OksarD/spm_model/documents/Honours Project parts list.xlsx

Parts List
Seller | Name/Description | Unit Quantity | Unit Cost | Total Cost | URL
RS Components | 50*80D 15W Bearing | 2 | $23.23 | $46.46 | https://au.rs-online.com/web/p/ball-bearings/6190777?gb=s
RS Components | 35*62D 14W Bearing | 2 | $14.89 | $29.78 | https://au.rs-online.com/web/p/ball-bearings/6190682?gb=s
RS Components | 20*42D 12W Bearing | 2 | $8.42 | $16.84 | https://au.rs-online.com/web/p/ball-bearings/6190424?gb=s
RS Components | 5*16D 5W Bearing | 3 | $3.89 | $70.02 | https://au.rs-online.com/web/p/ball-bearings/1883316?gb=s
RS Components | Timing pulley 3M 12T 9W | 3 | $9.30 | $27.90 | https://au.rs-online.com/web/p/belt-pulleys/2365389?gb=s
RS Components | Timing Belt 3M 140T 9W 420mm | 18 | $16.52 | $49.56 | https://au.rs-online.com/web/p/timing-belts/2042925?gb=s
Core Electronics | SparkFun 6 Degrees of Freedom Breakout - LSM6DSO (Qwiic) | 1 | $27.75 | $27.75 | SparkFun 6 Degrees of Freedom Breakout - LSM6DSO (Qwiic) | Buy in Australia | SEN-18020 | Sparkfun | Core Electronics (https://core-electronics.com.au/sparkfun-6-degrees-of-freedom-breakout-lsm6dso-qwiic.html)
Core Electronics | Slip Ring - 12 Wire (2A) | 1 | $47.90 | $47.90 | Slip Ring - 12 Wire (2A) | Buy in Australia | ROB-13065 | Sparkfun | Core Electronics (https://core-electronics.com.au/slip-ring-12-wire-2a.html)
Bambu Lab | PC (Black) 1kg Filament | 1 | $61.99 | $61.99 | https://au.store.bambulab.com/products/pc-filament
Bambu Lab | PETG HF (Blue) 1kg Filament | 1 | $30.99 | $30.99 | https://au.store.bambulab.com/products/petg-hf
 |  |  | Subtotal | $409.19
