OksarD/spm_model/Arduino/TiltTableTest/Read_me.txt

Press D to disable the motors.
Enter the command in the following format to tilt the table in the Roll, Pitch and Yaw directions: MR0P0Y0
where the number after R is the roll value, the number after P is the pitch value and the number after Y is the yaw value.
