OksarD/spm_model/Arduino/TiltTableTest/forward_kinematic_lookup.cpp

#include "project.hpp"

#ifdef FPK_YAW_LOOKUP_TABLE
const float yaw_table[] = {
  -999, -999, -999, -999, -999, -999, -999, -999, -999, -999, -999, -999, -999, -999, -999, -999, -999, -999, -999, -999, -999, -999, -999, -999, -999, -999, -999, -999, -999, -999, -999, -999, -999, -999, -999, -999, -999, -999, -999, -999, -999, -999, -999, -999, -999, -999, -999, -999, -999, -999, -999, -999, -999, -999, -999, -999, -999, -999, -999, 0.891973, 0.853819, 0.817185, 0.782015, 0.748247, 0.715818, 0.684663, 0.654719, 0.625927, 0.598229, 0.571574, 0.545913, 0.521203, 0.497406, 0.474486, 0.452415, 0.431168, 0.410722, 0.391061, 0.372173, 0.354047, 0.336677, 0.320060, 0.304196, 0.289086, 0.274734, 0.261144, 0.248322, 0.236273, 0.225001, 0.214510, 0.204798, 0.195862, 0.187694, 0.180280, 0.173602, 0.167633, 0.162342, 0.157694, 0.153645, 0.150150, 0.147161, 0.144627, 0.142497, 0.139494, 0.139255, 0.138050, 0.137066, 0.136265, 0.135614, 0.135082, 0.134645, 0.134280, 0.133971, 0.133703, 0.133464, 0.133246, 0.133042, 0.132850, 0.132668, 0.132494, 0.125346, 0.125095, 0.132043, -999, -999, -999, -999, -999, -999, -999, -999, -999, -999, -999, -999, -999, -999, -999, -999, -999, -999, -999, -999, -999, -999, -999, -999, -999, -999, -999, -999, -999, -999, -999, -999, -999, -999, -999, -999, -999, -999, -999, -999, -999, -999, -999, -999, -999, -999, -999, -999, -999, -999, -999, -999, -999, -999, -999, -999, -999, 
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
};
#endif
