OksarD/spm_model/(commit log)

2025-05-19 fpk WIP
    fpk not working but right idea
    use entire solve_ipk function instead
    [main.py, manipulator.py]
2025-05-20 fpk up to V vectors
    decoupled yaw at the input for fpk
    fpk works now for full range (+/- pi)
2025-05-22 solve for rotation matrix as opposed to co-ordinates
    The positional kinematics now output a rotation matrix, so any co-ordinate system can be used as an input, as long as a rotation matrix can be defined from it.
    YPR and axis-angle are tested.
2025-05-22 WIP angular velocity conversion
    convert velocities w_ypr into w_xyz function
    tried to verify Jacobian and velocity conversion function, but it only solved for ypr velocities of 1
    [main.py, manipulator.py]
2025-05-23 Verify Jacobian
    ypr to xyz conversion and Jacobian velocity matrix are verified with a discrete approximate calcualted from positional kinematics
2025-08-22 C++ inverse kinematics code
    Mr GPT had a hand in this one
    place eigen header library in cpp/libs/
    use the following to compile:
    g++ main.cpp CoaxialSPM.cpp -I libs/eigen-3.4.0
2025-08-22 Arduino Implementation of C++kinematics
    Working on speeding up code because I wrote it terribly and then ChatGPT re-wrote it even worse
    set cos(a1), sin(a2) etc... to constant variables to avoid trig compute.
    will do the same for eta_i(e)
    [CoaxialSPM.cpp, CoaxialSPM.hpp, TiltTableTest.ino]
2025-08-24 Further Trig Optimisation
    precalculated sin(eta(i)) and cos(eta(i))
    reduced trig function calls in R_x()/y/z matrix functions
    changed protocol to use lowercase y/p/r for velocity trajectory input instead of E/O/T for clarity
2025-08-25 fifo buffer (queue) with loop timing
    fifo buffer implemented as a queue with loop timing using millis().
    - could use a ringbuffer instead of a dynamic queue for speed
    - could use an interrupt-driven timer for the loop timing.
2025-08-25 trajectory generator
    module to generate regular trajectories
    uses forward-backward filter
    still need to generate trajectory from csv
2025-08-29 Precision timer WIP
    trajectory commands are sent with precision timer class
    timer should pause/resume for flow control but currently does not
2025-08-29 Flow Control working
    serial data from micro prints in real time while timer is sending commands to the micro
2025-08-29 Back to Queue based buffering
    seems to be more stable. The hardware serial buffer is only 256 bytes which is only a few commands. At high speed this buffer fills to quickly to get reliable flow control.
    Serial speedup is at 2 (commands are sent at double the speed that they are consumed) 1.5 was not enough
2025-08-29 Open loop working
    Using Serial.write() instead of print(). applicaiton-level flow control works with queue-based buffering
2025-09-20 fpk linear table array
    prints to a text file for copying into firmware
2025-09-22 WIP fpk_lookup table continuous
    attempted using fpk for lookup table. Not able to determine operating range using tis method.
    Used inverse method, sampling from ipk and using a nearest-point approximation to get the yaw value.
2025-09-23 fpk lookup tablworking.
    script can save or load a table and plot all three axes, Can format all three axes into a NxNx3 array, or just take a single value (in this case yaw) and format into txt
2025-10-04 fpk fixed
    actuator origin is not always -pi. included calculation for actuator origin in python and arduino spm kinematics
    [CoaxialSPM.cpp, TiltTableTest.ino, client.py, fpk_table.py, main.py, manipulator.py]
2025-10-05 arduino state machine
    state machine built for different modes of operation
2025-10-05 inserted fpk table
    added linear interpolation class
2025-10-07 interpolate forward kinematics
2025-10-07 Polling more frequently
    Added more frequent polling for stepper motors between I2C reads. This improves speed for closed-loop positional control, however to achieve the maximum possible speeds a hardware-timer driven stepper driver needs to be used.
2025-10-08 Quaternion Error
    this sucks ok so basically its now stable error-wise at the discontinuity (thank you quaternions), however now the pitch/roll error is unstable around (not exactly) at that point. I think i may have to bite the bullet on an axis-angle controller wish me luck.
    [CoaxialSPM.cpp, CoaxialSPM.hpp, TiltTableTest.ino, helpers.cpp, helpers.hpp, sensor_fusion.cpp, sensor_fusion.hpp]
2025-10-09 Axis-angle controller
    more numerically stable and direct controller -always takes teh shortest angular path
    also turns out the issue was a quarternion double-cover error do i didnt really need this but im glad i did it
    [TiltTableTest.ino, client.py, helpers.cpp, helpers.hpp, project.hpp, sensor_fusion.cpp, sensor_fusion.hpp]
2025-10-11 interrupt-driven steppers
    need to make setMaxSpeed() equivalent
2025-10-12 fix disable() motors
2025-10-12 saturated proportional controller
    PID compensator module added and used for position/homing.
2025-10-12 kalman filter converge
    let the kalman filter converge before homing by updating it a bunch of times
    dropped the position control gain slightly
2025-10-12 multithreaded client
    reads and prints all serial data from the micro, removing the serial backlog which causes random hanging.
2025-10-12 open-loop ypr tests
    hash command sends from device to python script
    open loop test sequences in python client: eg. OPR (test open loop pitch & roll).
    test automatically homes and positions device at initial location before sending trajectory
2025-10-14 fixed kinematics for non-standard spm parameters
    actuator origin was instantiated before origin vectors in arduino library, this was fixed
    forward kinematics for 90 degree spm-parameters was finxed, and the numerical solution for solve_fpk() was made robust by iterating through all possible initial assumptions, and back-ckecking using solve_ipk().
    [CoaxialSPM.cpp, helpers.hpp, main.py, manipulator.py]
2025-10-14 modified fpk_table to acutally use solve_fpk()
    that sampling trick with solve_ipk not only doesnt seem to give correct results but is also very slow. this is faster and hopefully will give working forward kinematics
    [fpk_table.py, main.py, manipulator.py]
2025-10-15 added prescaler to stepper driver library
    previously it only used 1us ticking (prescaler of 4). Now the prescaler can be adjusted (currently using 4us timing prescaler of 6)
2025-10-15 fixed stepper driver poor responsiveness
    stepper drivers no longer wait for next step before setting the new compare register. THey are set as soon as they can be (soonest value 1 tick past current)
    chenged prescaler to 7 to ensure setSpeed() can execute in 1 timer tick
    [TiltTableTest.ino, client.py, forward_kinematic_lookup.cpp, fpk_table.py, helpers.cpp, main.py, project.hpp, sensor_fusion.cpp]
2025-10-16 open-loop testing
    the formward kinematics was in column-major nor row-major format. Not sure why but it is actuallly fixed now. Interestinyl the gyro is causing the kalman filter to be off, but only for yaw. WIll need to look into this further but this can be used for open-loop VIcon testing
    [TiltTableTest.ino, client.py, fpk_table.py, helpers.cpp, main.py, sensor_fusion.hpp]
2025-10-18 microstepping was wrong this whole time
    goddammit ok so now the yaw table works. an additional out-of-bounds check is added to ensure that the motors do not hit each other
    [TiltTableTest.ino, client.py, helpers.cpp, helpers.hpp, project.hpp]
2025-10-18 EKF for gyro
    using an ekf for gyro prediction which seems to be much better. Still some minor misalignment between predicted and measured values in with yaw but we will see
    [TiltTableTest.ino, client.py, helpers.cpp, sensor_fusion.cpp, sensor_fusion.hpp]
2025-10-18 circular motion heuristic
    compensated for circular motion in accelerometer readings to marginally improve accuracy
    set loop timing back by the sample interval so the first reference signal is sent at t=0
2025-10-19 first attempt at a trajectory compensator
    axis-decoupled PID controllers. works pretty well actually. Some issues with high-frequency + high / frequently changing acceleration moves like triangle waves
    [TiltTableTest.ino, client.py, compensator.hpp, fpk_table.py, helpers.cpp, helpers.hpp, project.hpp]
2025-12-11 YPR closed-loop demo
    somehow this is the only one that works
    changed the microstepping to 4, adding the multiply by 2 into the setspeed function (since the driver only registers the rising edge)
    tuned the controller for the new microstepping value
2025-12-11 uploaded supporting documents
    [Honours Project parts list.xlsx]
2025-12-11 CAD LFS
